garatma/proyecto-embebidos/proyecto/informe/Presentación.odp

## Unidad UNO de Efectos

Sistemas Embebidos, 2019

Universidad Nacional del Sur

Manuel Garat

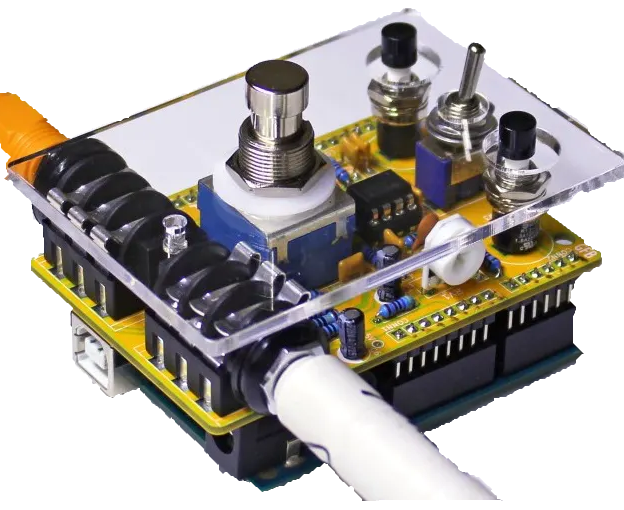
[picture p5: figure]

## Objetivos

## ⤳ Unidad de efectos genérica ⤳ Controlada por GUI en PC: ⤳ Efecto y ⤳ Modificador

Sistemas Embebidos, 2019

Universidad Nacional del Sur

Manuel Garat

## Hardware

## ⤳ Unidad de efectos: Arduino ⤳ Circuito de entrada y salida para acondicionar la señal

Sistemas Embebidos, 2019

Universidad Nacional del Sur

Manuel Garat

## Hardware

## [FOTO]

Sistemas Embebidos, 2019

Universidad Nacional del Sur

Manuel Garat

## Software

## ⤳ Efectos: C/C++ en Arduino ⤳ GUI: en Python para Linux y Windows

Sistemas Embebidos, 2019

Universidad Nacional del Sur

Manuel Garat

## Efectos

## Bit crusher

Sistemas Embebidos, 2019

Universidad Nacional del Sur

Manuel Garat

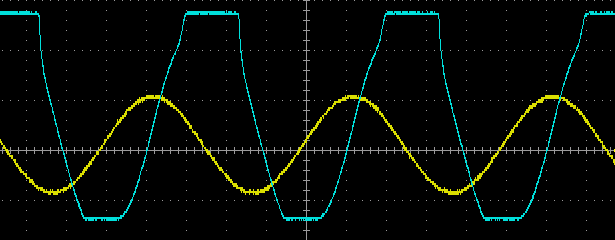
[picture p6: figure]

## Efectos

## Octavador Daft Punk

Sistemas Embebidos, 2019

Universidad Nacional del Sur

Manuel Garat

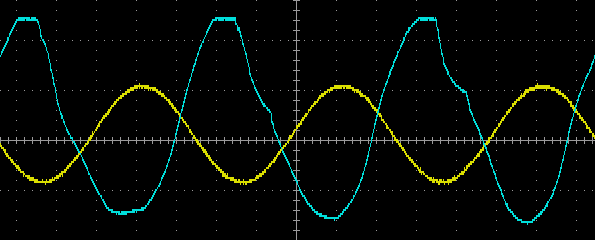
[picture p7: figure]

## Efectos

## Distorsión

Sistemas Embebidos, 2019

Universidad Nacional del Sur

Manuel Garat

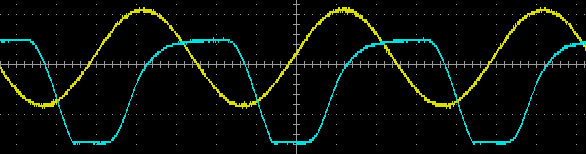
[picture p8: figure]

## Efectos

## Fuzz y Fuzz Controlado

Sistemas Embebidos, 2019

Universidad Nacional del Sur

Manuel Garat

## GUI

## GUI conectada al Arduino por puerto Serie

Sistemas Embebidos, 2019

Universidad Nacional del Sur

Manuel Garat


## Arduino

## ⤳ SerialEvent para recibir efecto y modificador ⤳ ISR para 1) leer ADC 2) switchear por efecto y aplicarlo 3) PWM con input modificado

Sistemas Embebidos, 2019

Universidad Nacional del Sur

Manuel Garat

## Inconvenientes

## ⤳ Poca memoria en Arduino imposibilita efectos temporales como delay ⤳ Circuitos de entrada/salida incómodos o delicados en protoboard

Sistemas Embebidos, 2019

Universidad Nacional del Sur

Manuel Garat

## Conclusiones

## ⤳ La comunicación entre PC y embebido permite , agregando poca complejidad. ⤳ Leer y manipular audio de forma digital no es algo sencillo, pero con pocas líneas se puede lograr un sónido totalmente distinto al original, e incluso uno nuevo.

Sistemas Embebidos, 2019

Universidad Nacional del Sur

Manuel Garat

## Referencias

## Fotos: Portada: https://create.arduino.cc/projecthub/electrosmash/arduino-uno-guitar-pedal-b2ba96 Osciloscopio: https://github.com/tardate/LittleArduinoProjects/tree/master/playground/pedalShieldUno

Sistemas Embebidos, 2019

Universidad Nacional del Sur

Manuel Garat
