garatma/proyecto-embebidos/proyecto/informe/código.png

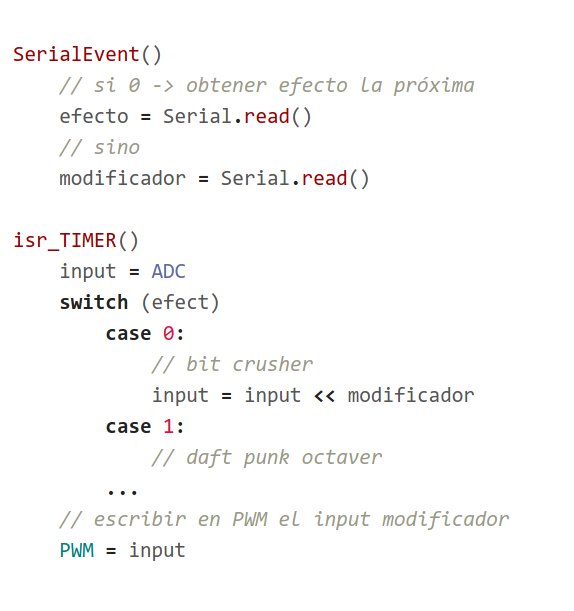
proyecto/informe/código.png
