garatma/proyecto-embebidos/proyecto/preliminar/circuito.png

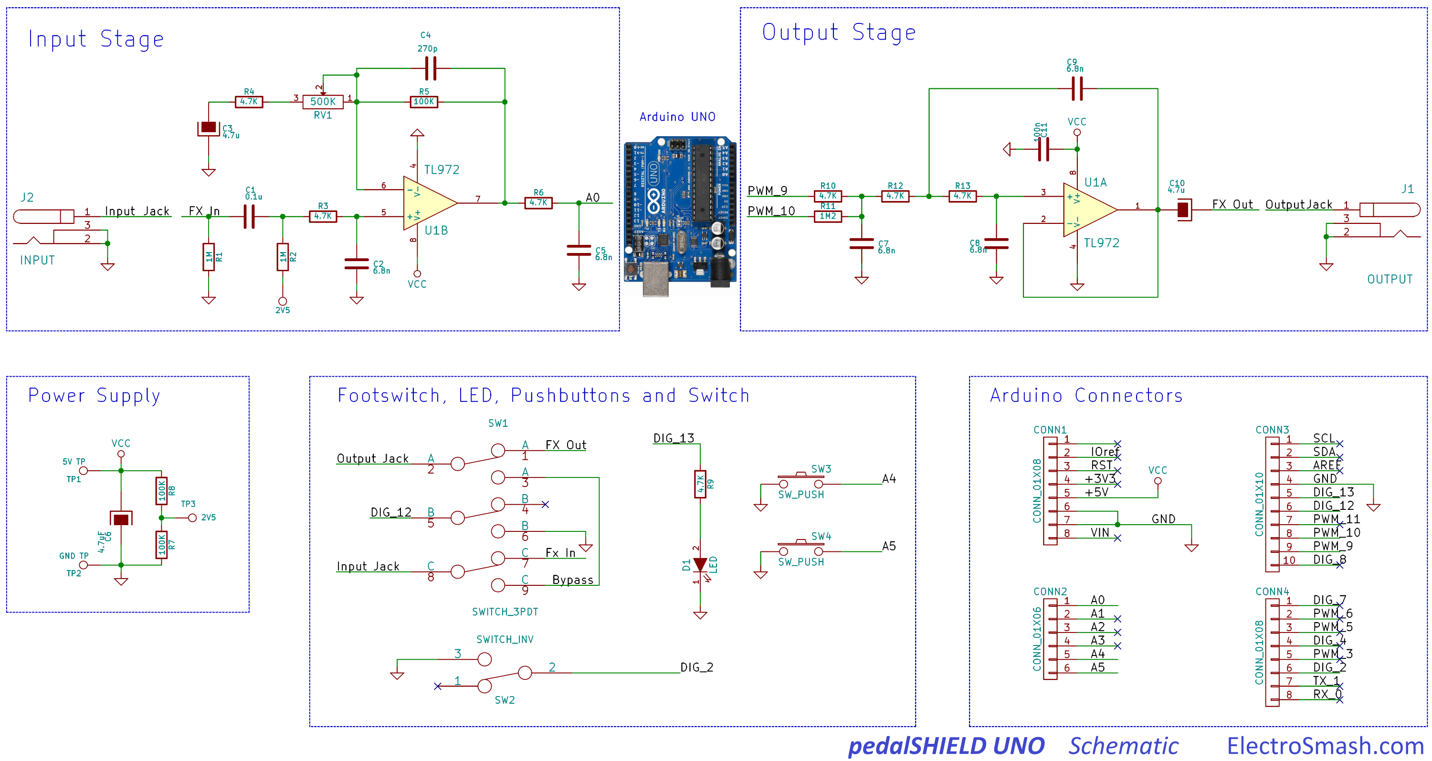
proyecto/preliminar/circuito.png
