garatma/proyecto-embebidos/proyecto/preliminar/foto-pcb.png

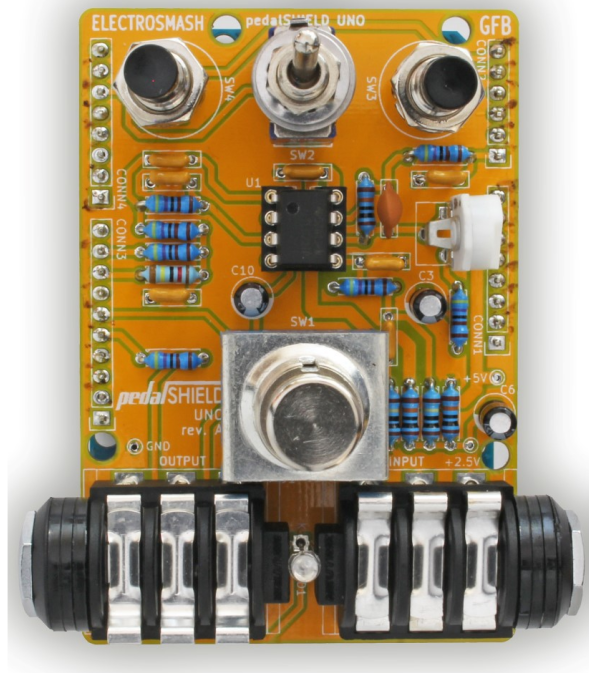
proyecto/preliminar/foto-pcb.png
