garatma/proyecto-embebidos/proyecto/preliminar/materiales.docx

pedalSHIELD UNO Bill of Materials.
Reference | Qty | Value | Description | Mouser Reference
Capacitors
C5,C2, C7, C8, C9 | 5 | 6.8n | Capacitor cerámica | SR211C682MARTR1
C3, C6, C10 | 3 | 4.7u | Capactiro electrolítico | ECE-A1EKA4R7
C1, C11 | 2 | 100n | Capacitor cerámica | SR211C104KARTR1
C4 | 1 | 270p | Capacitor cerámica | D271K20Y5PH63L6R

Resistors
R12,R13, R10, R6, R4, R3 | 7 | 4.7K | Resistencia, 1%,1/4W | MFR-25FRF52-4K7
R5, R7, R8, | 3 | 100K | Resistencia, 1%,1/4W | MFR-25FRF52-100K
R1, R2 | 2 | 1M | Resistencia, 1%,1/4W | MFR-25FRF52-1M
R11 | 1 | 1M2 | Resistencia, 1%,1/4W | MFR-25FRF52-1M2

Others
RV1 | 1 | 500K | resistor trimmer | 3319W-1-504
J1, J2 | 2 | 1/4 Jack audio | stereo 6.35mm jack | NMJ6HCD2
U1 | 1 | TL972 pdip-8 | op-amp rail-to-rail | 595-TL972IP
