garatma/proyecto-embebidos/proyecto/preliminar/materiales-foto.png

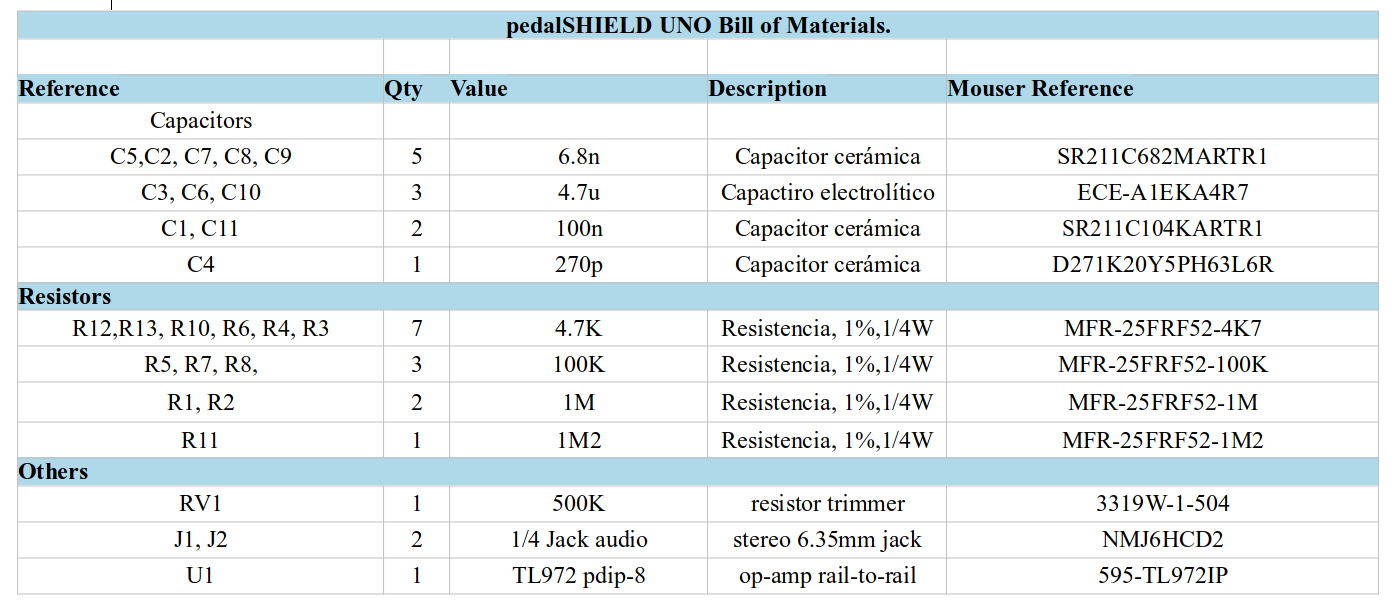
proyecto/preliminar/materiales-foto.png
