garatma/proyecto-embebidos/(commit log)

2019-11-15 inicio de gui en python
2019-11-17 field for port + start of gui-arduino comm
2019-11-23 testing the clink between gui and arduino
